Partha-Sarath-0/demo/09_Records_MD/correction_register.md

# GRAIL CFD — Correction Register
Every entry states the old assumption, the corrected assumption, the reason, what it affects,
and whether prior results must be discarded.

| ID | Old assumption | Corrected assumption | Reason | Affects | Discard old results? |
|---|---|---|---|---|---|
| CR-01 | Channel DIVERGES, Dh 5.20 → 8.345 mm | Channel CONVERGES, Dh 5.200 → 2.786 mm (as-meshed) | The diverging build violated ROADMAP A7/6.1/8.2 and fell outside Filing 1 dependent claim 1 (G must decrease, 0.35–1.00) | All hydraulic, thermal and efficiency results | YES — obsolete and scientifically invalid. Never a baseline, validation case, comparison or figure. |
| CR-02 | Single glazing pane, tau_glz = 0.91 | Double glazing, tau_glz_sys = 0.833 | The built collector has two panes (decision D2). Absorbed flux 567.1 → 519.1 W/m² at the design point | Optical chain, absorbed-flux BC, every efficiency figure | YES for any absorbed-flux value computed from 0.91 |
| CR-03 | Three-channel strip with plain SYMMETRY planes | Symmetry is not exact under alternating flow; field is glide-symmetric, not mirror-symmetric | Neighbour across a bridge midline runs the opposite direction; an adiabatic plane suppresses the lateral conduction Filing 1 depends on | Domain choice, all mechanism results | Not yet — decided by the domain-equivalence study (Gate 6) |
| CR-04 | lambda_G unspecified / assumed non-linear | lambda_G = 1.0 baseline | Confirmed against the as-built geometry: measured Dh(x) follows the linear-in-Dh law to +0.19 % … +0.49 % at xi = 0.10–0.90 | Grading sensitivity study | No |
| CR-05 | Root fillet 1.0 mm | Root fillet 0.5 mm (decision D4) | At 1.0 mm the tangent-blend section degenerates at h_s = 3.0 mm, flooring section scale at 0.745525 and making G_ratio 0.54 unreachable | Channel section, mesh near the root, fillet sensitivity 0.5–2.0 mm | YES for any result computed at r_fillet = 1.0 claiming G = 0.54 |
| CR-06 | Bridge width 34.8 mm (roadmap B3 baseline) | 31.299046 mm as built; investigate 20–60 mm | As-built value follows from ch_pitch − ch_w_in·max(1, G_ratio) | Lateral conduction, bridge sensitivity | No — 34.8 mm remains a valid sweep point |
| CR-07 | Manifold transition pockets as originally modelled | Pockets intentionally reduced; CFD circuit differs from the hardware-solid union by ~452.934 mm³ | Sub-0.5 mm lands would create poor CFD topology | Geometry provenance only | No — this is a deliberate modification, not an error |
| ~~CR-08~~ | ~~Grading ratio 0.540339~~ | **WITHDRAWN — see CR-09** | The premise was wrong. | — | — |
| **CR-09** | CR-08 claimed the STEP translation shifted the channel's small end, giving G = 0.535763 (−0.85 %) | **The geometry is faithful. G = 0.539935, −0.075 % from CAD.** The error was in the measurement tool, not the model: `gmsh.model.occ.getMass` mis-integrates the small trimmed outlet face by −0.72 % and the channel volume by +0.27 % | Direct integration of the true NURBS surface converges, under h-refinement of the sampling (NU = 96 → 2304), on the **CAD** values, not the OCC values. Inlet area → 28.0569 (CAD 28.0552, +0.006 %); outlet area → 7.9214 (CAD 7.9200, +0.018 %; OCC 7.8630, **+0.743 %**); volume → 18,643.7 (CAD 18,643.963, −0.0015 %) | Every quantity CR-08 said to restate. Reverted: the CAD values govern after all | **YES — discard CR-08 itself.** No CFD had been run on it. |
| **CR-10** | Assembly-level mesh renders showed the channel GROWING to Dh = 8.300 mm, a 1.0 mm root fillet, and stated 3,228,850 surface elements over 138 bodies at 20 mm cap with 23.97 m² of surface | Rebuilt on the corrected STEP: **128 of 129 solids, 299,544 triangles, 20 mm cap, 17.39 m² tessellated surface, envelope 1270 × 636 × 148 mm**; the channel SHRINKS 5.199 → 2.807 mm with a 0.5 mm root fillet | The old renders were made on the withdrawn diverging geometry (CR-01) and the 1.0 mm fillet (CR-05). They cannot be reused, re-captioned or cited | Figures M6–M10 and any body/element/area count quoted from them | **YES** — the superseded assembly renders are withdrawn with the geometry they depict |
| **CR-11** | (new) | The four manifold barrels (full periodic cylinder faces, CAD faces 430/478/542/590) are **rendered without their branch-port holes**, and the roll-bond solid region is built at a **nominal uniform 1.0 mm sheet thickness** | The barrels' port holes straddle the parametric seam, which defeats both gmsh's 2-D mesher and a point-in-polygon trim test; the real roll-bond upper sheet thins over the dome (marched thickness 0.22 – 1.32 mm, mean 1.08 – 1.23 mm) | M6–M10 only. Quantified, not hidden: the port area is computed from the CAD boundary curves and **subtracted** from the quoted surface area (−813.1 mm² over 92 arc segments); the solid region lands **+1.42 %** on the CAD sheet-pair volume | No — labelled ENGINEERING_ASSUMPTION, affects rendering and solid-region volume only, not any solved result |
| **CR-03 (closed)** | "Symmetry is not exact under alternating flow" — an argument, with the domain question left open | **Measured and confirmed.** An adiabatic symmetry plane inflates lateral bridge conduction by **+66.70 %**; a 3-channel strip is invalid under either boundary condition because the glide period is 2 channels; the **2-channel periodic** domain reproduces the full plate to Δη −0.31 %, Δ spread +2.51 %, Δ bridge −4.06 % | Five domains at identical cell size, with co-current as a control in which all four reduced domains reproduce the full plate exactly | Future reduced-domain work only. The campaign, mechanism study and all figures used the full 12-channel plate | No — nothing reported was computed on a reduced domain |
| **CR-12** | Lateral bridge conduction quoted as "170.84 W against 0.0000 W" | Co-current is **exactly zero by symmetry**, not merely small. The campaign reads 6.5e-11 to 9.1e-11 W (round-off); the grid study reads 0.000, 8.892, 0.000 and 3.345 W across four levels, and the 3-channel domain reads 1.050 W | Those nonzero readings are a sampling artefact of the bridge midline not coinciding with a cell face. With every channel flowing the same way the plate field is periodic in y and the midline gradient vanishes identically | How the contrast is quoted | No — quote it as an absolute figure (alternating 67 – 303 W across the campaign, ~20 W per midline at the design point), never as a ratio to zero |

| **CR-13** | Production campaign run at `nu_cfd = 3.4282`, the value measured on the medium 3-D grid | **Recomputed at `nu_cfd = 2.9238`**, the Richardson-extrapolated value from the three-level 3-D study (observed order p = 1.283, GCI 11.6 %). Rev 1 carried a **+17.25 %** bias on the one input the sensitivity analysis found controls 91 % of the uniformity difference | Same seed, same Latin Hypercube, same bounds, same gates, same grid — only `nu_cfd` changed, so every Rev 2 row pairs one-to-one with its Rev 1 twin and the difference is attributable to nothing else | Every campaign-derived number and every campaign figure (C10–C13, C17–C22). Paired shift: alternating plate spread −0.473 K, co-current −0.036 K | **No — Rev 1 is kept on disk** as `10_dataset/GRAIL_CFD_dataset_corrected.csv` and its figures under `12_figures/rev1_nu3.4282/`. Rev 2 (`GRAIL_CFD_dataset_rev2.csv`) supersedes it for every reported result |
| **CR-14** | Campaign average taken over 150 co-current and 141 alternating rows, the 9 missing rows dismissed as a convergence gate | **Rev 1's campaign average was censored.** The 9 rows the gate removed were all alternating, and all of them were the lowest-flow cases in the sample: 1.10 g/s mean against a 2.75 g/s campaign mean, none above 1.19 g/s, with a mean plate spread of 10.97 K against 4.69 K for alternating overall | Rev 2 loses no rows at all — the lower Nusselt number leaves the coupled solve better conditioned — so the 9 are recoverable and are not a random 9. Averaging with a sample's own hardest cases removed flatters alternating | The headline uniformity number, and the "benefit threshold" claim | **No result discarded, but the headline changes.** Δ plate spread: Rev 1 on 291 rows −20.09 %, Rev 2 on the same 291 rows −27.60 %, Rev 2 on all 300 rows **−20.83 ± 12.09 % (k = 2)**. The two corrections are of opposite sign and nearly cancel. The uncensored figure is the one to quote |
| **CR-15** | The 1.81 g/s mass-flow threshold below which alternating was said to be *worse* than co-current | **There is no threshold in the corrected campaign.** Every one of the 8 mass-flow bins from 1.23 to 4.27 g/s favours alternating in Rev 2; in Rev 1 the lowest bin read +7.75 % | Two causes, both in CR-13 and CR-14: the biased Nusselt number, and the fact that the censored rows were precisely the low-flow ones that set the threshold | Any statement of a minimum operating flow for the alternating arrangement | **YES — withdraw the threshold claim.** Note the bin-to-bin scatter is sampling noise: the co-current and alternating halves are two *independent* Latin Hypercube draws, so only the sign, which is consistent across all 8 bins, is robust |
| **CR-16** | Collapsing Nu(ξ) to a single number treated as a minor simplification | **It is the largest single model-form term in the assessment.** At the same developed-region mean, carrying the measured Nu(ξ) profile changes Δ plate spread from **−21.09 % to −6.85 %** — a shift of **14.2 percentage points**, larger than every numerical and input uncertainty combined. With the profile at its as-measured level the figure is −2.14 % | Closeout check A: the same solver at 220×240 run with a constant Nu, with the measured L3 profile, and with that profile rescaled to the constant's developed-region mean, which separates the cost of the profile's *shape* from the cost of its *level* | The confidence attached to the uniformity claim, not the sign of it — Δη moves only from −4.94 % to −5.51 % | **No result discarded**, but the uniformity benefit must be quoted as **model-form limited**. The campaign uses a constant Nu; a campaign carrying Nu(ξ) has not been run |
| **CR-17** | "3-D conjugate run on the meshed solid region" listed as an open item, implying it was pending rather than attempted | **Attempted and unsuccessful.** The two-region mesh builds and verifies (0 inverted cells, conformal interface at exactly NU × NX × 2 faces, fluid skewness 0.63 against 1.24 on the validated baseline), but `chtMultiRegionSimpleFoam` diverges from the first iteration: max \|U\| 155 m/s against an expected 0.00745 m/s | `simpleFoam` on the identical fluid region is stable (max \|U\| 0.098 m/s), so the mesh is solvable and the compressible segregated solver on it is not. Seven solver-setting changes were tried, including the exact scheme and relaxation set from the validated baseline case; none fixed it | Nothing — **no conjugate result is reported anywhere in this work** | **No.** Full account in `14_provenance/cht_attempt_record.md`. The question the run was meant to close stays open and is stated as open |
