Partha-Sarath-0/demo/Adaptive_Live_ANN_Concept.docx

# Adaptive / Live Artificial Neural Network (ANN)

Concept: Instead of training an ANN once on a fixed dataset, build a system that can adapt when new data arrives or when the underlying data pattern changes.

# 1. Traditional ANN

A conventional ANN is usually trained on a fixed dataset and then used for prediction.

Dataset → Train ANN → Model → Prediction

When new data arrives, the model is normally retrained manually or periodically.

# 2. Your Proposed Idea

The goal is an ANN that can continuously or periodically adapt itself to new information.

New Data → Check Pattern/Data Change → Check Model Performance → Update or Keep Model

# 3. Online / Incremental Learning

The first step is to allow the model to learn from new data without always starting training from zero.

Example:

- Day 1: 10,000 samples → train ANN
- Day 2: +500 samples → update ANN
- Day 3: +700 samples → update ANN
- Day 4: +1,000 samples → update ANN

# 4. Adaptive / Live ANN

A more advanced system monitors incoming data and detects whether the data distribution or relationship between inputs and outputs has changed.

Typical flow:

1. New data arrives
2. Process and validate the data
3. Detect data drift or concept drift
4. If the pattern is stable, continue using the current model
5. If a significant change is detected, update or retrain the model
6. Validate the new model
7. Deploy the new model only if it meets the required performance criteria

# 5. Important Terms

Online learning: Learning continuously or in small batches as new data arrives.

Incremental learning: Updating an existing model with additional data rather than rebuilding it from scratch.

Continual learning: Learning over an extended sequence of new data/tasks while trying to retain previous knowledge.

Data drift: A change in the distribution of the input data.

Concept drift: A change in the relationship between inputs and the target/output.

Model monitoring: Tracking prediction quality and other model-health metrics over time.

# 6. Proposed Architecture

Live Data → Data Processor → Drift Detector → ANN → Prediction → Performance Monitor

If drift/performance degradation is detected: New Data → Retraining/Incremental Update → Validation → New Model → Deployment

# 7. Recommended Development Stages

Stage 1: Build a normal ANN using Python and a fixed dataset.

Stage 2: Add incoming batches of new data and incremental/periodic training.

Stage 3: Add drift detection and model-performance monitoring.

Stage 4: Create an automated retraining and validation pipeline.

Stage 5: Connect the system to a genuinely live data source.

# 8. Key Design Principle

The ANN should not blindly retrain every time new data arrives. A robust adaptive system should decide when an update is necessary, whether incremental training is sufficient, whether a full retraining is needed, and whether the updated model performs better before deployment.

# 9. Practical Project Goal

A good first project would be a Python-based Adaptive ANN that receives simulated live data, detects a change in the data pattern, updates/retrains the ANN, compares the old and new models, and automatically deploys the updated model when its validation performance is acceptable.
