Partha-Sarath-0/demo/12_Stages_3-5-6-7/report/GRAIL_Stages_3-5-6-7_Report.docx

THE GRAIL COLLECTOR

Stages 3, 5, 6 and 7

ANN surrogate · NSGA-II optimisation · System model · Annual and techno-economic analysis, Berhampur (Odisha)

Item | Value
Input dataset | GRAIL_CFD_dataset_FINAL_rev4.2.csv (read-only, md5 13fd464c…)
Solver used for checks | GRAIL-CHT, Rev 4.2 settings, Richardson 2f(220) − f(110)
Weather | PVGIS TMY 19.313 N 84.810 E, 2005–2023, 8760 h (md5 63855e6f…)
Tariff | TPSODL LT domestic, 470 paise/kWh (51–200 kWh slab), FY 2025-26, retained FY 2026-27
Stage 4 (topology optimisation) | Removed from scope (future work)
Experimental validation | None claimed. All results are model results

# Contents

# 1. Summary

Stage | Result
3 ANN surrogate | Test R² 0.9994–0.9998 on 60 unseen cases (η MAPE 0.14 %). GPR slightly better (R² ≥ 0.9999); ANN kept as the roadmap model, GPR reported as the check
5 NSGA-II | Fronts for both arrangements. All 8 selected points re-run in GRAIL-CHT: η error ≤ 0.13 points, std ≤ 2.4 %, Δp ≤ 5.8 %. Parallel dominates on efficiency; alternating reaches the lowest plate std (2.83 K) at the top flow
6 System model | η0 0.597 / a1 2.00 W/m²K (alternating); η0 0.637 / a1 2.10 W/m²K (parallel). Fit error ≤ 0.23 points RMS; held-out points ≤ 0.24 points
7 Annual, Berhampur | Collector yield at 40 °C inlet: 1030 kWh/m²/yr parallel, 965 alternating (−6.3 %)
7 Techno-economic | Best size for 100 L/day: 2 modules (1.06 m²). Solar fraction 86 % / 83 %, cost of solar heat Rs 4.34 / 4.49 per kWh vs Rs 4.95 for an electric geyser, simple payback about 7.4 / 7.6 years (parallel / alternating)

Findings that the thesis must state as they are

1. Efficiency: parallel flow beats alternating in every stage — the dataset (−7.3 %), the Pareto fronts, the fitted curves and the annual yield (−6.3 %). Alternating only wins on plate uniformity at high flow, as Rev 4.1 found.

2. Converging channels: the optimiser pushes the grading ratio to its upper bound, 1.0 (a straight channel), and SHAP gives the grading inputs almost no effect on efficiency. Within the studied range, converging the channels does not raise efficiency; it raises pressure drop. DESIGN_REVIEW_REQUIRED for any claim that convergence improves thermal performance.

3. Pumping power in the channels is below 0.1 mW at every point, so it is not a real objective. Manifold and pump losses dominate in practice, and they are not modelled (manifold dimensions are still ENGINEERING_ASSUMPTION).

4. Optimum efficiency lies on the upper flow bound (4.5 g/s). The optimisation cannot say what happens beyond the sampled range.

5. Stagnation: with 4 modules the collector node reaches 427–442 K (154–168 °C) for up to 486 h/yr, outside the fitted range and probably above the TIM and PCM material limits. DESIGN_REVIEW_REQUIRED (overheat protection or smaller array). With the recommended 2 modules the maximum is 349–353 K.

# 2. Stage 3 — ANN surrogate

## 2.1 Method

- Inputs (9, sampled model inputs only, no derived columns): G_T, T_in, T_amb, wind, total mass flow, bridge width, grading ratio, grading exponent, arrangement flag.
- Targets: η, plate std, ln(Δp), mean plate temperature.
- Split: 240 training / 60 test cases, stratified by arrangement, seed 42. The test set was not used in any tuning step.
- Tuning: 5-fold cross-validated grid over 6 architectures × 5 L2 penalties; tanh activation, L-BFGS training, standardised inputs and targets.
- Final model: 10-member ensemble of the tuned network (different seeds); the ensemble spread is kept as an uncertainty indicator.
- Baselines on the same split: linear regression and Gaussian-process regression.

## 2.2 Results

Target | Architecture, α | CV R² | ANN test R² | ANN MAPE % | GPR test R² | Linear test R²
eta | [64, 32], 0.01 | 0.9994 | 0.9997 | 0.14 | 0.9999 | 0.8897
plate_std_K | [32, 32], 0.01 | 0.9993 | 0.9996 | 0.53 | 1.0000 | 0.8519
log_dp_Pa | [64, 32], 0.01 | 0.9992 | 0.9998 | 0.92 | 1.0000 | 0.9747
T_plate_mean_K | [64, 32], 0.01 | 0.9992 | 0.9994 | 0.06 | 1.0000 | 0.8813

Table 1. Surrogate accuracy on the 60-case hold-out set

The linear model reaches only R² 0.85–0.97, so the response is clearly non-linear; the ANN captures it. The GPR is marginally more accurate on this smooth 300-case dataset. Both are far inside the solver's own numerical uncertainty, so the choice does not change any conclusion.


Figure 15. Parity plots, test set

## 2.3 SHAP

Mean |SHAP| on the test set. Efficiency is driven by T_in, T_amb, flow and arrangement. The three geometric inputs (bridge, grading ratio, grading exponent) are two orders of magnitude weaker. Plate uniformity is driven by flow and irradiance. Pressure drop is driven by grading ratio and flow — the only place where the converging geometry matters strongly.

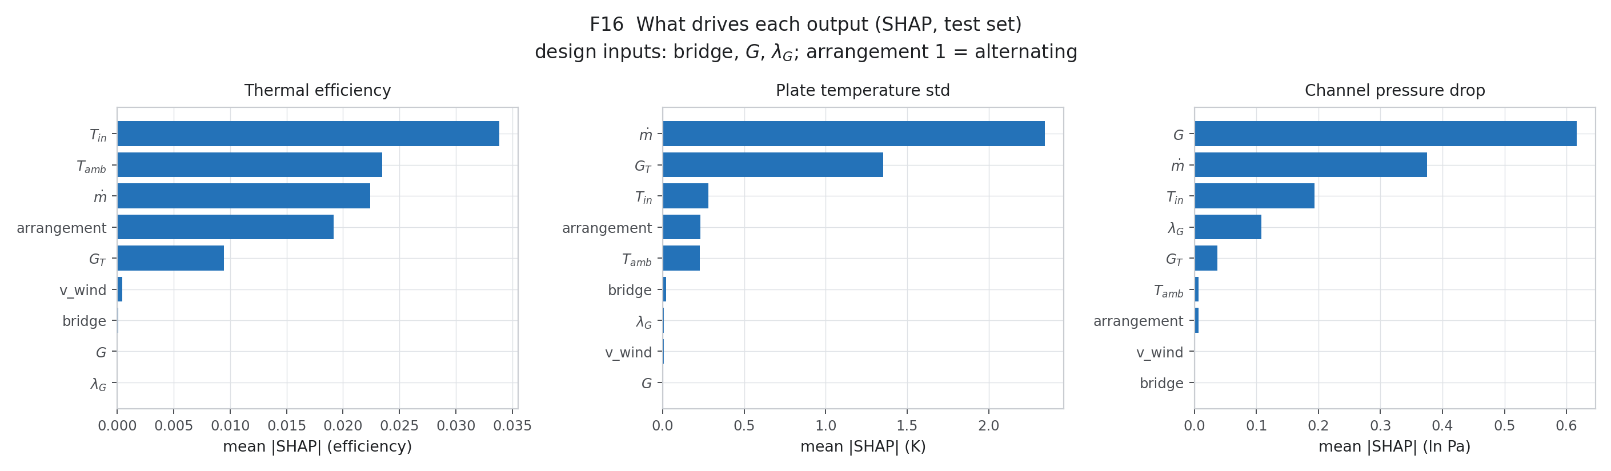
[picture p85: figure]

Figure 16. SHAP importance

# 3. Stage 5 — NSGA-II optimisation

- Variables inside the campaign bounds: flow 1.0–4.5 g/s, bridge 20–37 mm, grading ratio 0.35–1.0, grading exponent 0.5–2.0. Each arrangement was optimised separately and the fronts were merged.
- Reference point (ENGINEERING_ASSUMPTION, Berhampur clear-sky noon): G 800 W/m², T_in 313.15 K, T_amb 303.15 K, wind 3 m/s.
- Objectives: maximise η, minimise plate std, minimise pumping power. Population 200, 250 generations, seed 7.


Figure 17. Pareto fronts

Arrangement | Pick | Flow g/s | Bridge mm | Grading ratio | Exponent | η ANN | η GRAIL-CHT | std ANN K | std CHT K | Δp error %
alternating | max_eta | 4.49 | 31.9 | 0.998 | 0.50 | 0.5783 | 0.5784 | 2.87 | 2.83 | 5.8
alternating | min_std | 4.49 | 37.0 | 0.708 | 1.35 | 0.5773 | 0.5782 | 2.83 | 2.87 | 0.0
alternating | knee | 3.28 | 31.0 | 0.997 | 1.21 | 0.5599 | 0.5601 | 4.80 | 4.82 | -0.5
parallel | max_eta | 4.49 | 33.9 | 0.998 | 0.50 | 0.5940 | 0.5943 | 3.71 | 3.76 | 5.3
parallel | min_std | 4.49 | 37.0 | 0.998 | 2.00 | 0.5931 | 0.5944 | 3.68 | 3.76 | -0.3
parallel | knee | 2.94 | 27.6 | 0.998 | 1.40 | 0.5852 | 0.5850 | 5.64 | 5.64 | -0.7
alternating | as_built | 2.75 | 31.3 | 0.540 | 1.00 | 0.5467 | 0.5466 | 6.29 | 6.27 | -0.2
parallel | as_built | 2.75 | 31.3 | 0.540 | 1.00 | 0.5834 | 0.5830 | 6.00 | 6.01 | -0.0

Table 2. Selected points re-run with GRAIL-CHT (all converged, energy error < 0.5 %)

Every selected point was re-run with the solver; the surrogate holds to 0.13 efficiency points. The as-built design sits almost on each front. Moving it along the front is mainly a matter of flow: more flow gives higher efficiency and a flatter plate.

# 4. Stage 6 — System model

## 4.1 Efficiency correlations (virtual steady-state test)

The as-built geometry (bridge 31.29 mm, G 0.539935, λ 1.0) at the design flow of 2.75 g/s was run in GRAIL-CHT at 22 points: G ∈ {500, 900} W/m² × T_in ∈ {293, 308, 323, 332} K for the fit, and 3 held-out points (wind 0.5 and 4.9 m/s, T_amb 288 K). The ISO 9806 steady form was fitted on the mean fluid temperature.

Arrangement | η0 | a1 W/m²K | a2 W/m²K² | Fit RMS (points) | Held-out errors (points) | Wind 0.5 → 4.9 m/s
alternating | 0.5966 | 2.004 | 0.00038 | 0.15 | 0.24, -0.01, 0.15 | 0.5297 → 0.5279 → 0.5273
parallel | 0.6368 | 2.104 | 0.00000 | 0.23 | 0.15, 0.10, -0.04 | 0.5643 → 0.5639 → 0.5638

Table 3. Collector efficiency correlations (aperture 0.528 m², incident irradiance)

Parallel's unconstrained a2 was slightly negative (−0.0006), which is unphysical. It was refitted with a2 = 0; both fits are on record. The heat-loss coefficient a1 ≈ 2 W/m²K is very low because of the TIM, PCM and VIP stack. η0 ≈ 0.60–0.64 is set mainly by the optical factor 0.6489. Wind changes efficiency by less than 0.3 points, so no wind term was fitted. The fit covers Tm − Ta from −3 to 40 K.


Figure 18. Efficiency curves

## 4.2 Dynamic collector and tank model

- Collector: one thermal node in the ISO 9806 quasi-dynamic form. Effective capacity 33.5 kJ/m²K from the stack masses (PCM counted as sensible heat only — PCM latent heat is deferred).
- Incidence angle modifier: Kb = 1 − 0.10(1/cos θ − 1), diffuse 0.90 (ENGINEERING_ASSUMPTION; the solver has no angular optics).
- Tank: 100 kg, fully mixed, UA 1.5 W/K. Pump control: on at ΔT > 7 K, off below 2 K, off above 358 K. 60 s step. The tank first law closes to 0.000 kWh/yr.
- Load: 100 L/day delivered at 318.15 K through a mixing valve, drawn 40/20/40 % morning/noon/evening; mains water at the 24 h mean ambient temperature; electric top-up at 95 % efficiency.

## 4.3 Roadmap Section 11 — GNU Octave implementation

Section 11 of the roadmap specifies MATLAB/Simulink. No MATLAB or Simulink licence was available, so the system model was also written as MATLAB-compatible .m files and run in GNU Octave 8.4.0 (folder 13_Octave_system_model). It uses the same equations and inputs but its own solar-position routine (NOAA rather than NREL SPA). The results match the Python model: solar fraction within 0.000004, solar heat within 0.003 kWh/yr, cost of heat within 0.00004 Rs/kWh, collector-only yield within 0.004 kWh/m²/yr, peak collector temperature within 0.17 K. The tank energy balance closes to about 1e-12 kWh. No Simulink model exists. The block-diagram part of Section 11 was built in Scilab Xcos instead (Section 4.4).

## 4.4 Roadmap Section 11 — block-diagram model in Scilab Xcos

Simulink needs a MATLAB licence, so the same collector–tank system was drawn as a block diagram in Scilab Xcos 2024.0.0, the free equivalent (folder 14_Xcos_block_diagram_model, file GRAIL_system.zcos). The diagram has 24 blocks:

- Hourly inputs: G_eff, T_amb, T_mains and draw, from the unchanged TMY file.
- Two integrators for the collector and tank temperatures.
- A hysteresis block for the pump (7/2 K) with a 358 K tank limit.
- Expression blocks for the two energy balances and for six heat rates, which are integrated and logged to the workspace.
- The solver is LSodar (tolerance 1e-6, maximum step 60 s). A full year runs in 7–10 s.

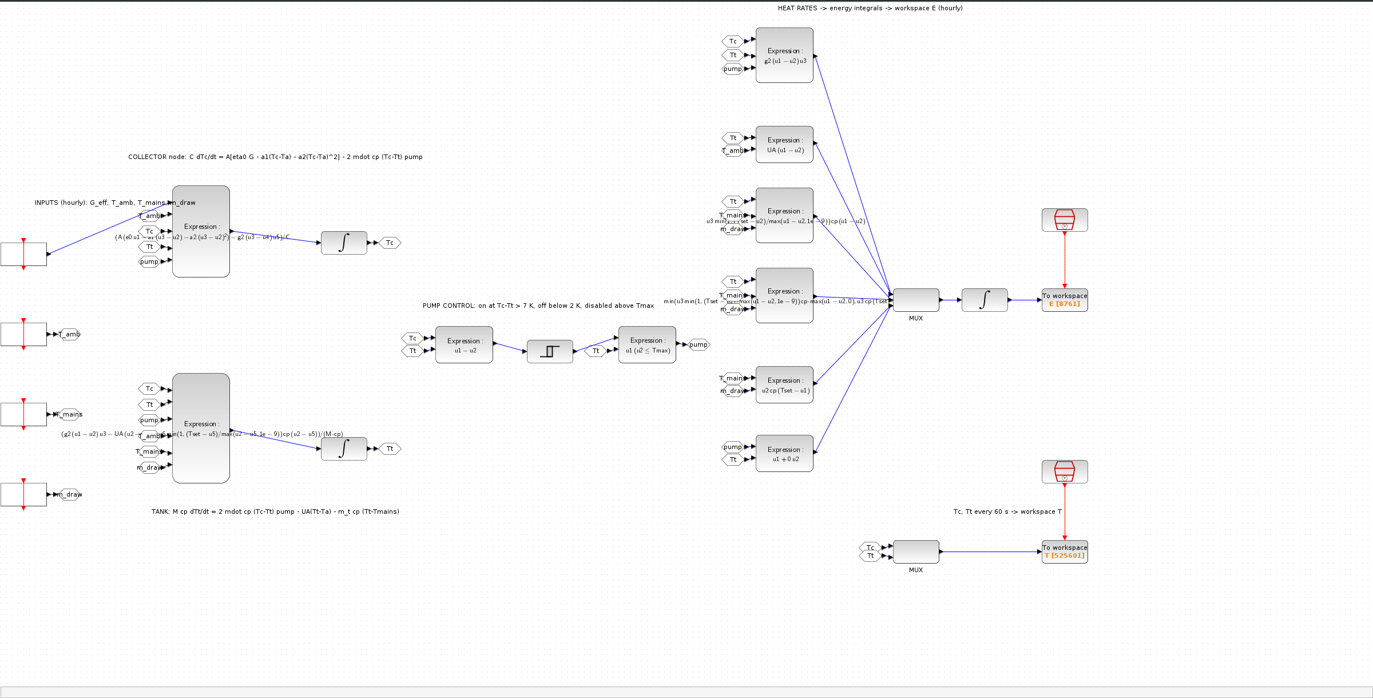
[picture p86: figure]

Figure 18a. GRAIL SDHW system as a Scilab Xcos block diagram

Arrangement | Modules | Solar kWh/yr | SF Xcos % | SF Octave (same equations) % | SF Stage 7 baseline % | Max Tc K
alternating | 2 | 626.0 | 81.42 | 81.46 | 83.04 | 348.0
parallel | 2 | 648.4 | 84.34 | 84.36 | 85.84 | 352.0
alternating | 4 | 749.7 | 97.51 | 97.52 | 97.91 | 429.8
parallel | 4 | 754.1 | 98.08 | 98.08 | 98.43 | 443.8

Table 3a. Xcos results and verification (Berhampur TMY, 100 L/day at 45 °C)

Verification (model-to-model only; no experimental validation):

- Against an Octave solution of the same equations at a 10 s step, solar heat agrees within 0.04 % and solar fraction within 0.03 points in all four cases.
- The tank first law closes to better than 1e-10 kWh.
- Re-importing the saved .zcos file reproduces the results.

The Xcos model treats each hour's hot-water draw as a continuous flow; the Stage 7 model draws it as a pulse at the start of the hour. This modelling choice lowers the solar fraction by 1.5–1.6 points at 2 modules and 0.4 points at 4 modules. The ranking (parallel above alternating) and the sizing conclusion (2 modules) are unchanged. The Stage 7 figures remain the reported baseline.

# 5. Stage 7 — Annual and techno-economic analysis, Berhampur

## 5.1 Weather processing

- The time alignment was tested, not assumed: GHI = DNI cos z + DHI closes to 0.17 W/m² when the solar position is taken at the stated UTC timestamp, against 14.3 W/m² with a half-hour shift.
- Plane of array: 19.3° tilt, facing south, Hay-Davies, albedo 0.2 → 1976 kWh/m²/yr. Isotropic model 1955, Perez 2001; tilts between 15° and 25° are within 0.5 %.
- Cross-check: at 35° tilt the result is 1935 kWh/m²/yr, against 1965 in the PVGIS PV report you downloaded (a different database) — 1.5 % apart.

Arrangement | Yield at 40 °C inlet (kWh/m²/yr) | Yield at 60 °C inlet | Annual efficiency on POA at 40 °C
parallel | 1030 | 882 | 52.1 %
alternating | 965 | 823 | 48.8 %

Table 4. Collector-only annual yield at fixed inlet temperature


Figure 19. Monthly yield, sizing and cost of heat

## 5.2 Household system sizing and economics

Arrangement | Modules | Area m² | Solar fraction | Solar heat kWh/yr | Max collector K | Capex Rs | Payback yr | NPV Rs | Cost of heat Rs/kWh
alternating | 1 | 0.53 | 50.0 % | 385 | 329 | 16500 | 10.8 | -3464 | 6.00
alternating | 2 | 1.06 | 83.0 % | 638 | 349 | 21000 | 7.6 | 2526 | 4.49
alternating | 3 | 1.58 | 94.7 % | 728 | 389 | 25500 | 8.0 | 1620 | 4.69
alternating | 4 | 2.11 | 97.9 % | 753 | 427 | 30000 | 9.2 | -1976 | 5.25
parallel | 1 | 0.53 | 53.2 % | 409 | 331 | 16500 | 10.1 | -2461 | 5.65
parallel | 2 | 1.06 | 85.8 % | 660 | 353 | 21000 | 7.4 | 3435 | 4.34
parallel | 3 | 1.58 | 96.0 % | 738 | 405 | 25500 | 7.9 | 2053 | 4.62
parallel | 4 | 2.11 | 98.4 % | 757 | 442 | 30000 | 9.1 | -1748 | 5.22

Table 5. Sizing sweep for a 100 L/day household (15 years, 8 % discount rate, 1 % O&M, 15 W pump)

- Tariff: TPSODL domestic 470 paise/kWh (51–200 kWh slab), unchanged for FY 2026-27; electricity duty excluded (conservative). At the 570 paise slab, savings rise by 21 %.
- Capex: ENGINEERING_ASSUMPTION of Rs 12,000 fixed + Rs 4,500 per module, anchored to market flat-plate systems (Rs 20,000–30,000 for 100 L/day plus Rs 3,000–10,000 installation). The GRAIL prototype cost is unknown; the base case (4 modules) is also run at Rs 22,000 and Rs 45,000 in stage7_results.json.
- Two modules minimise the cost of heat. Four modules are oversized: the tank sits at its limit for 533–726 h/yr, 40 % of the collected heat is lost from the tank, and the collector stagnates at high temperature.

# 6. Assumptions, open items and files

Tag | Item
ENGINEERING_ASSUMPTION | Tilt 19.3° S; IAM b0 0.10; C_eff 33.5 kJ/m²K; tank 100 kg, UA 1.5 W/K; 100 L/day at 45 °C; draw profile; mains = 24 h mean ambient; pump 15 W; geyser 95 %; capex model; 15 yr, 8 %, 1 % O&M
ENGINEERING_ASSUMPTION | NSGA-II reference operating point; design flow 2.75 g/s for the annual runs
DESIGN_REVIEW_REQUIRED | Converging-channel benefit (not supported for efficiency within the range studied)
DESIGN_REVIEW_REQUIRED | Stagnation temperature against TIM and PCM limits for arrays of 3 or more modules; overheat protection
Deferred (your decision) | PCM latent heat, 3-D radiation and optical model, full 3-D campaign; manifold dimensions
Limitation | Annual results rely on the fitted correlation outside its fitted range only during stagnation hours; wind above 5 m/s (1,605 h) is outside the trained range but has less than 0.3 points of effect

Folder | Contents
21_surrogate | ann_surrogate.pkl, stage3_report.json, test parity CSVs, SHAP arrays
23_optimisation | pareto_fronts.csv, selected_points_surrogate.csv, verification_vs_GRAIL-CHT.csv
22_system | virtual_test_matrix.csv, efficiency_correlations.json
20_annual | weather file (unchanged), closure test, stage7_results.json, sizing_sweep.csv, hourly SDHW CSVs, monthly yield
24_figures_stage3to7 | F15–F19
13_Octave_system_model | MATLAB/Octave .m model, compare_with_python.m (PASS), continuous-draw reference for Xcos, README
14_Xcos_block_diagram_model | GRAIL_system.zcos block diagram, build/run scripts, inputs, results, verification (PASS), README
tools | stage3_ann.py, stage5_nsga2.py, stage5_verify.py, cht_point.py, stage6_testmatrix.py, stage6_fit.py, stage7_weather.py, stage7_annual.py, stage3to7_figures.py

GRAIL Collector — Stages 3, 5, 6, 7
