Partha-Sarath-0/demo/16_JSON_Python_Mirror/README.md

# 16 — JSON ↔ Python mirror

Every JSON file in the package (65) now has a Python file next to it in this folder. There are
two parts:

1. **`mirror/`: the same data as Python.** There is one `.py` file per JSON, at the same path,
   for example `07_Results_JSON/validation_and_uncertainty/gci_plate.json` →
   `mirror/07_Results_JSON/validation_and_uncertainty/gci_plate.py`. Each file contains:
   * `DATA`, the full content as an indented Python dict or list in the same key order;
   * a header saying what the file holds, which script made the JSON, the MD5/SHA-256 of the
     JSON, and an outline of its keys;
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
