Partha-Sarath-0/demo/06_Datasets/GRAIL_CFD_dataset_rev4.2_with_Stages3-7.xlsx

Sheet: README
GRAIL Collector - CFD dataset rev 4.2 with Stage 3-7 results
Dataset_rev4.2: the 300 GRAIL-CHT cases, copied cell for cell from GRAIL_CFD_dataset_FINAL_rev4.2.csv.
The CSV file itself is unchanged (MD5 13fd464c09a7c26fbe0fa75a5f5113b3, the MD5 recorded by Stage 3).

Sheet: Dataset_rev4.2
case_id | geometry_version | solver | arrangement | f_interdig | G_T_W_m2 | T_in_K | T_amb_K | v_wind_m_s | mdot_total_kg_s | mdot_channel_kg_s | bridge_mm | g_ratio | lambda_G | Dh_in_mm | Dh_out_mm | A_in_mm2 | A_out_mm2 | Re_in | Re_out | mu_Pa_s | dp_channel_Pa | W_pump_W | q_abs_W_m2 | T_sky_K | h_wind_W_m2K | T_out_K | dT_fluid_K | Qu_W | eta | T_plate_mean_K | T_plate_max_K | T_plate_min_K | plate_spread_K | plate_std_K | P90_K | P95_K | P99_K | R4_K4 | Tmean_pow4_K4 | T_R4_K | Q_solar_W | Q_rad_W | Q_conv_W | Q_rear_W | U_L_W_m2K | T_glass_mean_K | lateral_bridge_W | energy_error_pct | outer_iters | residual | converged | Nu_closure_input | Nu_closure_basis | dataset_rev | k_model | outer_cap | plate_nx | plate_ny
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

Sheet: Stage6_Correlations
Stage 6 - ISO 9806 steady-state efficiency, q = eta0 G - a1 dT - a2 dT^2 (dT = Tm - Ta)
Quantity | Alternating | Parallel | Unit | Source file
eta0 | 0.5966 | 0.6368 | - | 12_Stages_3-5-6-7/system_model/efficiency_correlations.json
a1 | 2.004 | 2.104 | W/m2K | 12_Stages_3-5-6-7/system_model/efficiency_correlations.json
a2 | 0.00038 | 0.00000 | W/m2K2 | 12_Stages_3-5-6-7/system_model/efficiency_correlations.json
Fit RMS error | 0.151 | 0.229 | points | 12_Stages_3-5-6-7/system_model/efficiency_correlations.json
Fit max error | 0.318 | 0.434 | points | 12_Stages_3-5-6-7/system_model/efficiency_correlations.json
a2 constraint | not active | a2 >= 0 enforced |  | 12_Stages_3-5-6-7/system_model/efficiency_correlations.json
Unconstrained a2 (parallel) |  | -0.00061 | W/m2K2 | negative (unphysical), so refitted with a2 = 0; both fits on record
Held-out GRAIL-CHT points (not used in the fit)
Arrangement | G | T_in | T_amb | wind | eta_cht | eta_fit | err_pp | |error| (points) | Source file
alternating | 900.0000 | 323.1500 | 303.1500 | 0.5000 | 0.5297 | 0.5273 | 0.2386 | 0.239 | 12_Stages_3-5-6-7/system_model/efficiency_correlations.json
alternating | 900.0000 | 323.1500 | 303.1500 | 4.9000 | 0.5273 | 0.5274 | -0.0116 | 0.012 | 12_Stages_3-5-6-7/system_model/efficiency_correlations.json
alternating | 700.0000 | 332.1500 | 288.1500 | 3.0000 | 0.4500 | 0.4485 | 0.1532 | 0.153 | 12_Stages_3-5-6-7/system_model/efficiency_correlations.json
parallel | 900.0000 | 323.1500 | 303.1500 | 0.5000 | 0.5643 | 0.5627 | 0.1507 | 0.151 | 12_Stages_3-5-6-7/system_model/efficiency_correlations.json
parallel | 900.0000 | 323.1500 | 303.1500 | 4.9000 | 0.5638 | 0.5628 | 0.1050 | 0.105 | 12_Stages_3-5-6-7/system_model/efficiency_correlations.json
parallel | 700.0000 | 332.1500 | 288.1500 | 3.0000 | 0.4809 | 0.4813 | -0.0423 | 0.042 | 12_Stages_3-5-6-7/system_model/efficiency_correlations.json
Largest held-out error (points) | 0.239
Fit based on 22 GRAIL-CHT runs (G 500/900 W/m2 x 4 inlet temperatures, both arrangements) plus these held-out points.

Sheet: Stage7_Annual
Stage 7 - Annual performance, Berhampur (PVGIS TMY 2005-2023, tilt 19.3 deg S, Hay-Davies)
Quantity | Value | Unit | Source file
Global horizontal irradiation (GHI) | 1864.9 | kWh/m2/yr | 12_Stages_3-5-6-7/annual/stage7_results.json
Plane-of-array irradiation (POA) | 1976.1 | kWh/m2/yr | 12_Stages_3-5-6-7/annual/stage7_results.json
POA after incidence-angle losses | 1854.7 | kWh/m2/yr | 12_Stages_3-5-6-7/annual/stage7_results.json
Collector yield, 40 C (313.15 K) inlet - parallel | 1029.9 | kWh/m2/yr | 12_Stages_3-5-6-7/annual/stage7_results.json
Collector yield, 40 C (313.15 K) inlet - alternating | 965.2 | kWh/m2/yr | 12_Stages_3-5-6-7/annual/stage7_results.json
Collector yield, 60 C (333.15 K) inlet - parallel | 882.5 | kWh/m2/yr | 12_Stages_3-5-6-7/annual/stage7_results.json
Collector yield, 60 C (333.15 K) inlet - alternating | 823.4 | kWh/m2/yr | 12_Stages_3-5-6-7/annual/stage7_results.json
Weather cross-check at 35 deg tilt against the PVGIS PV report (PVGIS-ERA5)
Month | PVGIS H(i)_m (kWh/m2) |  | Source file
1 | 204.15 |  | 12_Stages_3-5-6-7/annual/weather/PVGIS_PVreport_35deg_crosscheck.csv
2 | 191.88 |  | 12_Stages_3-5-6-7/annual/weather/PVGIS_PVreport_35deg_crosscheck.csv
3 | 204.32 |  | 12_Stages_3-5-6-7/annual/weather/PVGIS_PVreport_35deg_crosscheck.csv
4 | 183.05 |  | 12_Stages_3-5-6-7/annual/weather/PVGIS_PVreport_35deg_crosscheck.csv
5 | 165.31 |  | 12_Stages_3-5-6-7/annual/weather/PVGIS_PVreport_35deg_crosscheck.csv
6 | 122.77 |  | 12_Stages_3-5-6-7/annual/weather/PVGIS_PVreport_35deg_crosscheck.csv
7 | 110.99 |  | 12_Stages_3-5-6-7/annual/weather/PVGIS_PVreport_35deg_crosscheck.csv
8 | 120.04 |  | 12_Stages_3-5-6-7/annual/weather/PVGIS_PVreport_35deg_crosscheck.csv
9 | 132.93 |  | 12_Stages_3-5-6-7/annual/weather/PVGIS_PVreport_35deg_crosscheck.csv
10 | 165.15 |  | 12_Stages_3-5-6-7/annual/weather/PVGIS_PVreport_35deg_crosscheck.csv
11 | 176.26 |  | 12_Stages_3-5-6-7/annual/weather/PVGIS_PVreport_35deg_crosscheck.csv
12 | 188.42 |  | 12_Stages_3-5-6-7/annual/weather/PVGIS_PVreport_35deg_crosscheck.csv
PVGIS year (sum) | 1965.3 | kWh/m2/yr
This model at 35 deg | 1935.5 | kWh/m2/yr | 12_Stages_3-5-6-7/annual/stage7_weather_check.txt (tilt 35 line)
Difference | -1.5%
SDHW sizing sweep: 100 L/day delivered at 45 C (318.15 K)
arrangement | n_modules | aperture_m2 | solar_fraction | Q_solar_kWh | yield_kWh_m2 | tank_loss_kWh | hours_tank_limit | max_collector_K | hours_collector_above_393K | capex_Rs | net_saving_Rs | simple_payback_yr | discounted_payback_yr | NPV_Rs | LCOH_Rs_kWh | Source file
alternating | 1 | 0.528 | 0.500 | 384.777 | 728.744 | 110.813 | 0 | 329.050 | 0 | 16500.000 | 1523.040 | 10.834 | 27 | -3463.574 | 5.999 | 12_Stages_3-5-6-7/annual/sizing_sweep.csv
alternating | 2 | 1.056 | 0.830 | 638.425 | 604.570 | 241.530 | 0 | 349.080 | 0 | 21000.000 | 2748.570 | 7.640 | 13 | 2526.329 | 4.485 | 12_Stages_3-5-6-7/annual/sizing_sweep.csv
alternating | 3 | 1.584 | 0.947 | 728.471 | 459.894 | 402.228 | 75 | 389.362 | 0 | 25500.000 | 3168.362 | 8.048 | 14 | 1619.525 | 4.688 | 12_Stages_3-5-6-7/annual/sizing_sweep.csv
alternating | 4 | 2.112 | 0.979 | 752.809 | 356.444 | 508.784 | 533 | 426.590 | 270 | 30000.000 | 3274.062 | 9.163 | 18 | -1975.733 | 5.254 | 12_Stages_3-5-6-7/annual/sizing_sweep.csv
parallel | 1 | 0.528 | 0.532 | 408.811 | 774.264 | 118.154 | 0 | 330.788 | 0 | 16500.000 | 1640.169 | 10.060 | 22 | -2461.007 | 5.651 | 12_Stages_3-5-6-7/annual/sizing_sweep.csv
parallel | 2 | 1.056 | 0.858 | 659.968 | 624.969 | 266.450 | 0 | 353.159 | 0 | 21000.000 | 2854.676 | 7.356 | 12 | 3434.537 | 4.339 | 12_Stages_3-5-6-7/annual/sizing_sweep.csv
parallel | 3 | 1.584 | 0.960 | 737.889 | 465.839 | 435.707 | 197 | 405.361 | 29 | 25500.000 | 3219.046 | 7.922 | 14 | 2053.353 | 4.622 | 12_Stages_3-5-6-7/annual/sizing_sweep.csv
parallel | 4 | 2.112 | 0.984 | 756.787 | 358.327 | 533.325 | 726 | 441.513 | 486 | 30000.000 | 3300.702 | 9.089 | 17 | -1747.707 | 5.217 | 12_Stages_3-5-6-7/annual/sizing_sweep.csv
DESIGN_REVIEW_REQUIRED: with 4 modules the collector stagnates above 420 K (max_collector_K).

Sheet: Economics
Economics - 2-module system (1.056 m2), 100 L/day at 45 C, Berhampur
Input | Value | Unit | Basis / source
Electricity tariff | 4.70 | Rs/kWh | TPSODL LT domestic 51-200 kWh/month slab, 470 paise/kWh (FY 2025-26, retained FY 2026-27); electricity duty excluded (conservative)
Electric geyser efficiency | 0.95 | - | 12_Stages_3-5-6-7/annual/stage7_results.json
Capex fixed part | 12000 | Rs | ENGINEERING_ASSUMPTION (Stage 7 sizing sweep)
Capex per module | 4500 | Rs/module | ENGINEERING_ASSUMPTION (Stage 7 sizing sweep)
Modules | 2 | - | best size from the sizing sweep
Life | 15 | yr | 12_Stages_3-5-6-7/annual/stage7_results.json
Discount rate | 0.08 | - | 12_Stages_3-5-6-7/annual/stage7_results.json
O&M per year (fraction of capex) | 0.01 | - | 12_Stages_3-5-6-7/annual/stage7_results.json
Capex (formula) | 21000 | Rs | 12,000 + 4,500 per module; checked against capex_Rs in the sizing sweep below
Capex check vs sizing sweep | OK
Cost of heat from an electric geyser | 4.95 | Rs/kWh | tariff / geyser efficiency
Result (2 modules) | Parallel | Alternating | Unit
Solar fraction | 85.8% | 83.0% | -
Solar heat delivered | 660.0 | 638.4 | kWh/yr
Cost of solar heat (LCOH) | 4.34 | 4.49 | Rs/kWh
Simple payback | 7.4 | 7.6 | yr
Discounted payback | 12 | 13 | yr
Net saving per year | 2854.675843 | 2748.570303 | Rs/yr
NPV over life | 3434.537043 | 2526.32893 | Rs
Solar heat cheaper than the geyser? | yes | yes
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
