Partha-Sarath-0/demo/03_CAD/strip_3ch.step

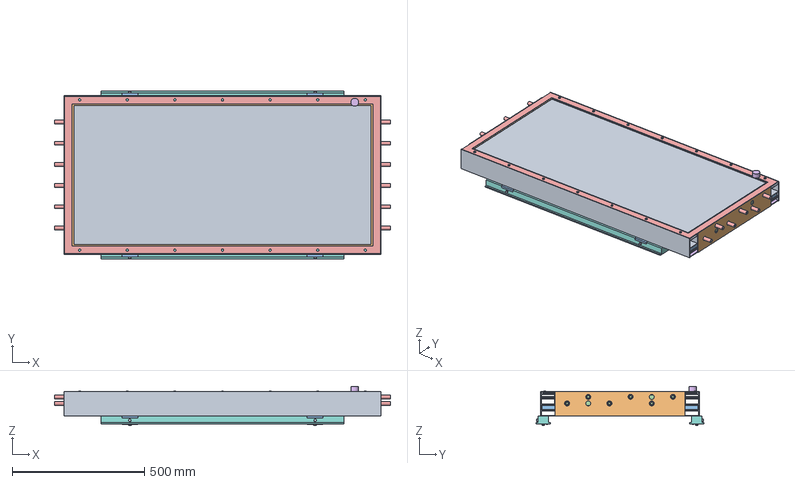
[picture p87: CAD file, 2026-09-27]
03_CAD/strip_3ch.step
1270.0 x 636.0 x 148.0 mm
