Partha-Sarath-0/demo/(list of files, cad)

Other CAD files:
03_CAD/strip_2ch.step
03_CAD/Grail_Collector_2.step
03_CAD/Grail_Collector_2.f3d
