Partha-Sarath-0/demo/15_Run_in_VSCode/requirements-tested.txt

numpy==2.4.4
scipy==1.17.1
pandas==3.0.2
scikit-learn==1.8.0
matplotlib==3.10.9
shap==0.51.0
pymoo==0.6.2
pvlib==0.15.2
