Partha-Sarath-0/demo/14_Xcos_block_diagram_model/xcos_results.csv

arrangement | n_modules | Q_coll_kWh | Q_loss_kWh | Q_draw_kWh | Q_solar_kWh | Q_load_kWh | pump_h | solar_fraction | Tt_end_K | Tc_max_K | closure_kWh | run_s
alternating | 2 | 875.0688 | 247.4734 | 626.0240 | 626.0240 | 768.8527 | 2834.80 | 0.814231 | 311.6838 | 347.962 | 4.435e-11 | 7
parallel | 2 | 921.9051 | 271.7412 | 648.4200 | 648.4200 | 768.8524 | 2839.84 | 0.843361 | 313.1696 | 352.030 | 5.851e-12 | 7
alternating | 4 | 1263.1744 | 509.2234 | 749.7092 | 749.7092 | 768.8544 | 2153.05 | 0.975099 | 334.6819 | 429.849 | 1.756e-11 | 9
parallel | 4 | 1292.9795 | 534.1814 | 754.0794 | 754.0794 | 768.8529 | 2056.03 | 0.980785 | 338.7897 | 443.822 | -5.925e-11 | 10
