Partha-Sarath-0/demo/12_Stages_3-5-6-7/optimisation/verification_vs_GRAIL-CHT.csv

arrangement | pick | eta_ann | eta_cht | std_ann | std_cht | dp_ann | dp_cht | Tmax_cht | converged | eta_err_pp | std_err_pct | dp_err_pct
alternating | max_eta | 0.5783396809372161 | 0.5784045931358048 | 2.872147953612248 | 2.833736084435269 | 11.349513495309292 | 10.731233539797 | 331.16749476694264 | True | -0.00649121985887291 | 1.3555203460181737 | 5.761499395380678
alternating | min_std | 0.5773477095586155 | 0.5781669983215713 | 2.827119022391441 | 2.866042013611642 | 20.186822514733244 | 20.17955103179932 | 331.27216791210554 | True | -0.08192887629557832 | -1.3580746909970152 | 0.036033918309008865
alternating | knee | 0.5599334846351087 | 0.5601425484400887 | 4.800084215885446 | 4.8160331312619515 | 7.506468502127948 | 7.547142893978121 | 340.341762743778 | True | -0.02090638049799809 | -0.3311629081821951 | -0.5389376141616058
parallel | max_eta | 0.593998900538118 | 0.5943249543820797 | 3.7130349574170807 | 3.7626445233929204 | 11.261201030896554 | 10.697312629797816 | 327.8280445865765 | True | -0.032605384396167114 | -1.3184760257688368 | 5.27130897836905
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
