Partha-Sarath-0/demo/12_Stages_3-5-6-7/system_model/virtual_test_matrix.csv

arrangement | G_T | T_in | T_amb | v_wind | bridge_mm | g_ratio | lam_G | mdot_total | T_out_K | dT_fluid_K | Qu_W | eta | T_plate_mean_K | T_plate_max_K | T_plate_min_K | plate_spread_K | plate_std_K | dp_channel_Pa | T_glass_mean_K | converged | e110 | e220 | it | eta_110 | eta_220
alternating | 500.0 | 293.15 | 303.15 | 3.0 | 31.285944 | 0.539935 | 1.0 | 0.00275 | 307.058683479511 | 13.908683479511012 | 159.88031659697907 | 0.6056072598370419 | 311.2340277625729 | 316.17016427910323 | 299.4779576826951 | 16.69220659640814 | 4.19669008036926 | 37.384910092395515 | 301.27444701501145 | True | 0.0001136131483711097 | 0.00011383836353466109 | 494 | 0.6067234408473738 | 0.6061653503422079
alternating | 500.0 | 308.15 | 303.15 | 3.0 | 31.285944 | 0.539935 | 1.0 | 0.00275 | 320.7616859846332 | 12.611685984633198 | 144.9713303933586 | 0.5491338272475705 | 324.6995131414677 | 329.2673540582264 | 313.79677850513076 | 15.470575553095614 | 3.889616522550084 | 27.885113947424724 | 302.3621258085525 | True | 0.00011776874838901481 | 0.00011888492184016058 | 498 | 0.5502063546067244 | 0.5496700909271475
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
