Partha-Sarath-0/demo/12_Stages_3-5-6-7/system_model/virtual_test_matrix_with_x.csv

arrangement | G_T | T_in | T_amb | v_wind | bridge_mm | g_ratio | lam_G | mdot_total | T_out_K | dT_fluid_K | Qu_W | eta | T_plate_mean_K | T_plate_max_K | T_plate_min_K | plate_spread_K | plate_std_K | dp_channel_Pa | T_glass_mean_K | converged | e110 | e220 | it | eta_110 | eta_220 | Tm | dT | x | q | x_in
alternating | 500.0 | 293.15 | 303.15 | 3.0 | 31.285944 | 0.539935 | 1.0 | 0.00275 | 307.058683479511 | 13.908683479511012 | 159.88031659697907 | 0.6056072598370419 | 311.2340277625729 | 316.17016427910323 | 299.4779576826951 | 16.69220659640814 | 4.19669008036926 | 37.38491009239552 | 301.27444701501145 | True | 0.0001136131483711 | 0.0001138383635346 | 494 | 0.6067234408473738 | 0.6061653503422079 | 300.10434173975545 | -3.0456582602445224 | -0.0060913165204890445 | 302.8036299185209 | -0.02
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
