Partha-Sarath-0/demo/12_Stages_3-5-6-7/surrogate/test_parity_T_plate_mean_K.csv

case_id | true | pred | pred_std
PAR_071 | 332.31855414604416 | 332.36675439664566 | 0.12898037148399014
PAR_041 | 329.2066622565519 | 329.04713473488926 | 0.08449541926985892
PAR_088 | 299.3238795340518 | 299.5226537343148 | 0.08013384663977592
PAR_124 | 312.1094590901258 | 312.3340735727592 | 0.11694008715079283
PAR_001 | 309.8162873646046 | 309.465965955004 | 0.13369872979709907
PAR_091 | 340.99920414213426 | 341.13088977402447 | 0.09519485355514941
ALT_104 | 349.9888066960905 | 350.06886339052056 | 0.15758482495935786
PAR_140 | 340.67379670795094 | 340.7378787436512 | 0.09787764683444009
ALT_027 | 341.60104207813 | 341.70243231119906 | 0.07320729993240295
PAR_048 | 324.6398649840532 | 324.7882733578746 | 0.11310349803432009
ALT_138 | 387.4916329814852 | 384.50233841200543 | 0.3790786410333171
ALT_102 | 314.97726142745324 | 315.0360416263857 | 0.10670972735064228
PAR_106 | 314.94463039335955 | 314.89620461732164 | 0.12311958258385088
ALT_070 | 355.63481640554846 | 356.1342188907397 | 0.12236484608916653
ALT_028 | 307.6857797386612 | 307.541723809902 | 0.07979832081944067
ALT_142 | 334.041177628844 | 333.75279499499266 | 0.16174731164379388
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
