Partha-Sarath-0/demo/12_Stages_3-5-6-7/surrogate/test_parity_eta.csv

case_id | true | pred | pred_std
PAR_071 | 0.4716297507751055 | 0.4707834850419016 | 0.0005439270336942671
PAR_041 | 0.5259197852674934 | 0.526135762902402 | 0.0004530327933629734
PAR_088 | 0.6479693345231291 | 0.6479278061703153 | 0.00044388882617886255
PAR_124 | 0.604546594447295 | 0.6043176789360785 | 0.0008189140810031615
PAR_001 | 0.6455453650420525 | 0.645999579106133 | 0.0004632278563937646
PAR_091 | 0.565925439305678 | 0.5662074976763721 | 0.0005110534981258926
ALT_104 | 0.5618246913477413 | 0.5619869449675019 | 0.0006555393355842792
PAR_140 | 0.5011704970504609 | 0.5001327416954471 | 0.0006771794713082209
ALT_027 | 0.4985747641294351 | 0.4981344995728258 | 0.00025715757431762714
PAR_048 | 0.5974916541290554 | 0.5971055301826604 | 0.0003480949529144024
ALT_138 | 0.4437627150146358 | 0.4462608021551445 | 0.001079720600894167
ALT_102 | 0.5180664068136497 | 0.5186543728936663 | 0.0008890038444296829
PAR_106 | 0.6296816855634342 | 0.6297436779413137 | 0.0007581988207485367
ALT_070 | 0.5146326063169406 | 0.5125573150697071 | 0.0005006115717489507
ALT_028 | 0.5857534056127403 | 0.5849662163987929 | 0.00045589167560929213
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
