Partha-Sarath-0/demo/12_Stages_3-5-6-7/surrogate/test_parity_log_dp_Pa.csv

case_id | true | pred | pred_std
PAR_071 | 2.050401500415159 | 2.0510556967461833 | 0.007130576604959046
PAR_041 | 1.3442971664691588 | 1.3255382944230267 | 0.009561102612125123
PAR_088 | 2.9843796023317717 | 2.972388469674704 | 0.007511995164335718
PAR_124 | 2.7610214412213963 | 2.7682504786580404 | 0.008264190587661311
PAR_001 | 4.085731091242841 | 4.088453011370679 | 0.013868366731705911
PAR_091 | 2.067103665173512 | 2.0605245958889227 | 0.003559976189791074
ALT_104 | 4.1806220408889505 | 4.186232733857029 | 0.013693718459072222
PAR_140 | 2.20262314223709 | 2.213270803902163 | 0.008599181495649226
ALT_027 | 3.1516827857543723 | 3.139257905659894 | 0.005988032890885389
PAR_048 | 4.37216745641088 | 4.377622656664908 | 0.00789295154046997
ALT_138 | 1.0527520578086949 | 1.03749589012136 | 0.008577855150918953
ALT_102 | 3.2638496515093887 | 3.2643263742373754 | 0.0069441357849796825
PAR_106 | 2.4925467039237024 | 2.4894975239416572 | 0.003283603178406637
ALT_070 | 2.352707428781746 | 2.338565919306953 | 0.0067014434478728105
ALT_028 | 3.9748759212805767 | 3.982849899337084 | 0.009336783609929495
ALT_142 | 3.372943542454046 | 3.3539009737368133 | 0.01717993068355036
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
