Partha-Sarath-0/demo/12_Stages_3-5-6-7/surrogate/test_parity_plate_std_K.csv

case_id | true | pred | pred_std
PAR_071 | 3.536707893663536 | 3.5260415493067634 | 0.017236166504381995
PAR_041 | 10.663512418571369 | 10.742052353538593 | 0.05842411407376754
PAR_088 | 4.86492000560694 | 4.864905600828099 | 0.018784111331891746
PAR_124 | 3.8772479356336 | 3.8753881110316897 | 0.04211780189521231
PAR_001 | 6.627371766479743 | 6.569751138712047 | 0.07062974828042694
PAR_091 | 10.145015983669852 | 10.144638873018529 | 0.024951929093891528
ALT_104 | 6.523384059833222 | 6.580754775209213 | 0.03090059036997796
PAR_140 | 5.1733468400514 | 5.182133427228573 | 0.026421256400167483
ALT_027 | 2.9986847266077863 | 2.983516619762395 | 0.014585037149563721
PAR_048 | 5.3709384149837 | 5.389208778943299 | 0.016369225477530874
ALT_138 | 19.468339879352616 | 19.055718636203743 | 0.18950344454931894
ALT_102 | 2.333021273308401 | 2.314738322927502 | 0.032117764137457386
PAR_106 | 4.17695953239348 | 4.20986633754269 | 0.0123443882567185
ALT_070 | 14.303101730256154 | 14.369550894285544 | 0.036662057807587016
ALT_028 | 2.892976288481195 | 2.9042238735744563 | 0.029362458281288212
ALT_142 | 5.01914212866467 | 4.990130329204487 | 0.03355242644350994
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
