Partha-Sarath-0/demo/13_Octave_system_model/octave_results.csv

arrangement | n_modules | aperture_m2 | solar_fraction | Q_solar_kWh | Q_load_kWh | tank_loss_kWh | max_collector_K | pump_kWh | closure_kWh | capex_Rs | net_saving_Rs | simple_payback_yr | discounted_payback_yr | NPV_Rs | LCOH_Rs_kWh
alternating | 1 | 0.528 | 0.500458 | 384.778 | 768.851 | 110.813 | 329.05 | 45.871 | 1.33e-12 | 16500 | 1523.05 | 10.834 | 27 | -3463.5 | 5.9990
alternating | 2 | 1.056 | 0.830359 | 638.423 | 768.851 | 241.532 | 349.08 | 42.543 | -3.35e-13 | 21000 | 2748.56 | 7.640 | 13 | 2526.2 | 4.4851
alternating | 3 | 1.584 | 0.947479 | 728.471 | 768.851 | 402.238 | 389.44 | 38.438 | 9.73e-13 | 25500 | 3168.36 | 8.048 | 14 | 1619.5 | 4.6876
alternating | 4 | 2.112 | 0.979134 | 752.808 | 768.851 | 508.777 | 426.59 | 31.990 | 1.69e-12 | 30000 | 3274.06 | 9.163 | 18 | -1975.7 | 5.2540
parallel | 1 | 0.528 | 0.531719 | 408.813 | 768.851 | 118.155 | 330.79 | 46.249 | -3.31e-14 | 16500 | 1640.17 | 10.060 | 22 | -2461.0 | 5.6507
parallel | 2 | 1.056 | 0.858378 | 659.965 | 768.851 | 266.453 | 353.16 | 42.644 | -3.34e-12 | 21000 | 2854.66 | 7.356 | 12 | 3434.4 | 4.3394
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
