Partha-Sarath-0/demo/17_Simulink_MATLAB_model/GRAIL_system_v21 Landscape.pdf

# GRAIL_system_v21

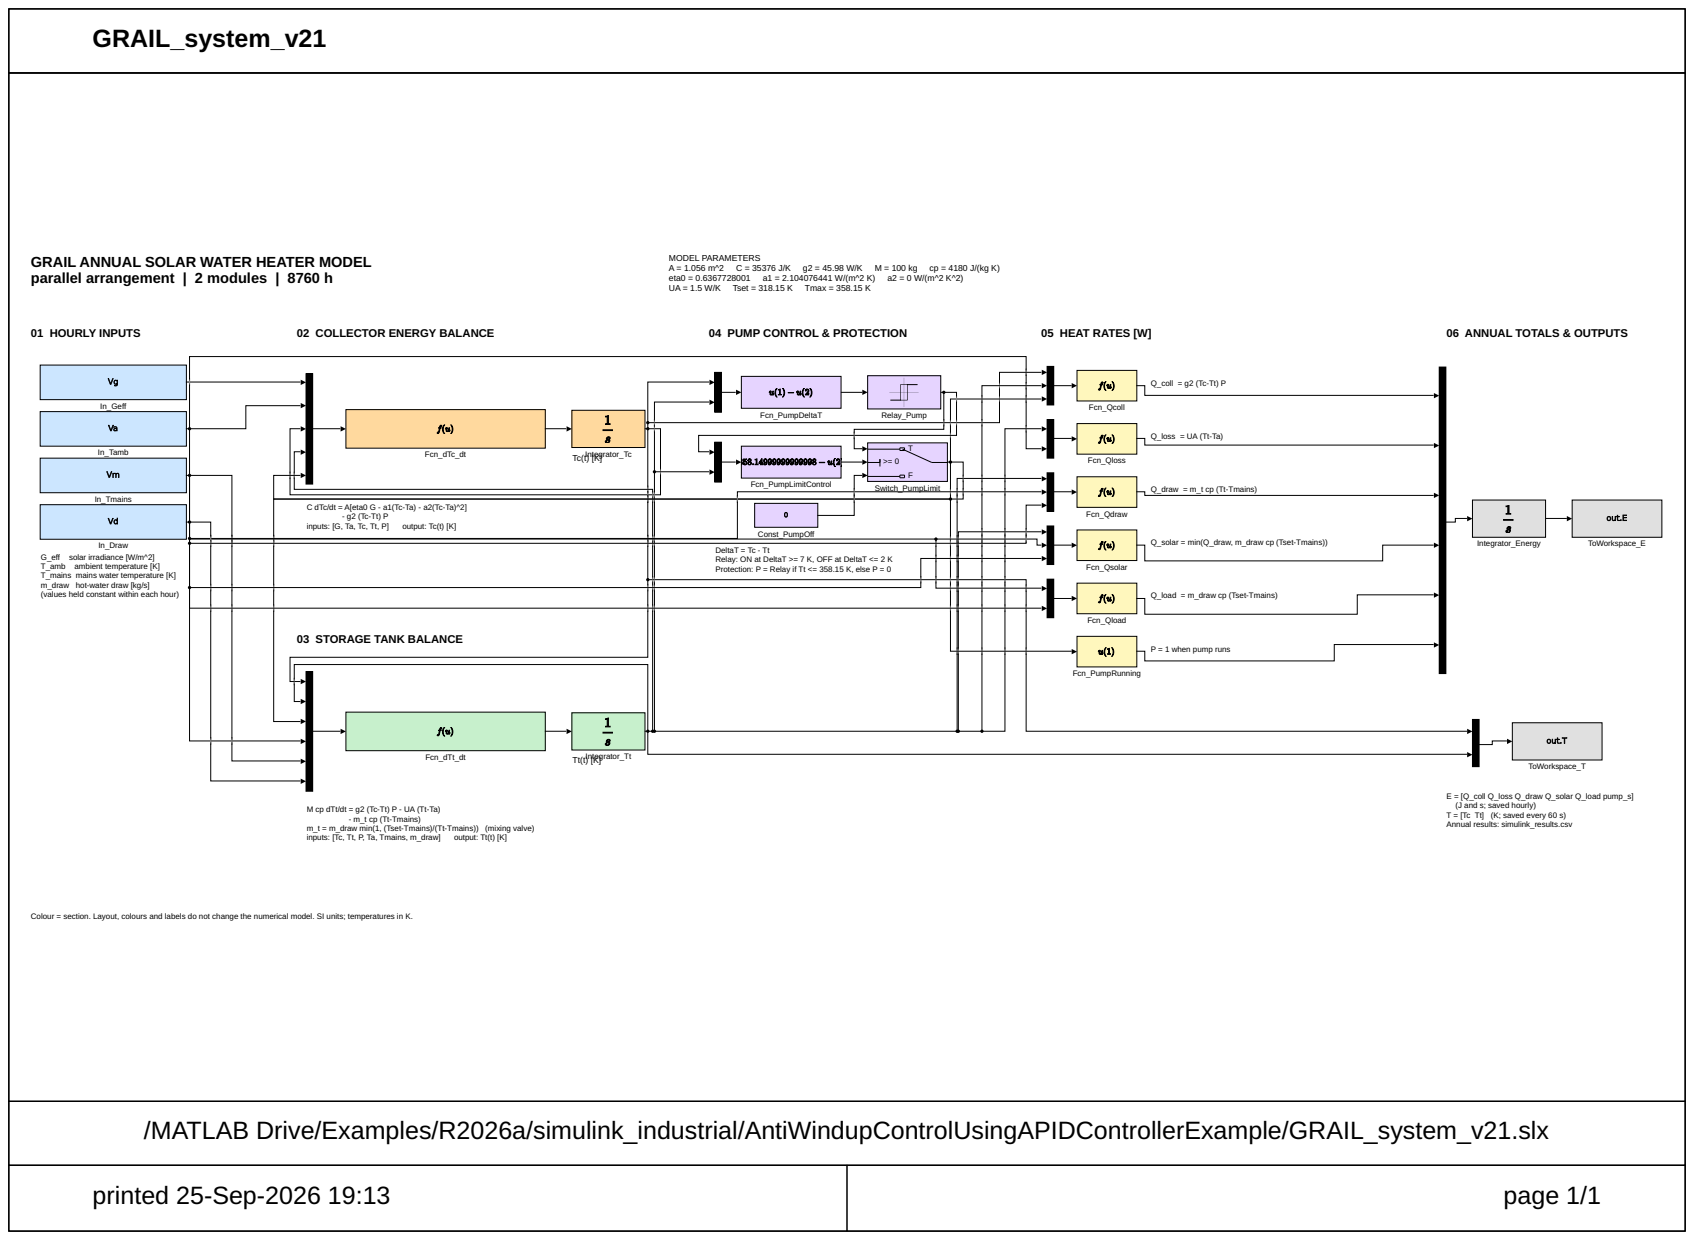
[picture p99: page 1]
Q_coll = g2 (Tc-Tt) P; inputs: [Tc, Tt, P, Ta, Tmains, m_draw]; output: Tt(t) [K]; inputs: [G, Ta, Tc, Tt, P]; output: Tc(t) [K]; 04 PUMP CONTROL & PROTECTION; 05 HEAT RATES [W]; 06 ANNUAL TOTALS & OUTPUTS; 01 HOURLY INPUTS; 02 COLLECTOR ENERGY BALANCE; MODEL PARAMETERS; cp = 4180 J/(kg K) eta0 = 0.6367728001; Tset = 318.15 K; Tmax = 358.15 K; In_Geff; In_Tamb; In_Tmains; In_Draw; Fcn_dTc_dt; Integrator_Tc; Fcn_dTt_dt; Integrator_Tt; Fcn_PumpDeltaT; Relay_Pump; Fcn_PumpLimitControl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

GRAIL ANNUAL SOLAR WATER HEATER MODEL
parallel arrangement | 2 modules | 8760 h

Q_loss = UA (Tt-Ta)

C dTc/dt = A[eta0 G - a1(Tc-Ta) - a2(Tc-Ta)^2]

Q_draw = m_t cp (Tt-Tmains)

Q_solar = min(Q_draw, m_draw cp (Tset-Tmains))

G_eff solar irradiance [W/m^2] T_amb ambient temperature [K] T_mains mains water temperature [K] m_draw hot-water draw [kg/s]

DeltaT = Tc - Tt Relay: ON at DeltaT >= 7 K, OFF at DeltaT <= 2 K

Protection: P = Relay if Tt <= 358.15 K, else P = 0

(values held constant within each hour)

Q_load = m_draw cp (Tset-Tmains)

03 STORAGE TANK BALANCE

P = 1 when pump runs

M cp dTt/dt = g2 (Tc-Tt) P - UA (Tt-Ta)
- m_t cp (Tt-Tmains) m_t = m_draw min(1, (Tset-Tmains)/(Tt-Tmains)) (mixing valve)

E = [Q_coll Q_loss Q_draw Q_solar Q_load pump_s]
(J and s; saved hourly) T = [Tc Tt] (K; saved every 60 s) Annual results: simulink_results.csv

Colour = section. Layout, colours and labels do not change the numerical model. SI units; temperatures in K.

/MATLAB Drive/Examples/R2026a/simulink_industrial/AntiWindupControlUsingAPIDControllerExample/GRAIL_system_v21.slx

# Sample Times for 'GRAIL_system_v21'

Color Annotation | Description | Value
Cont | Continuous
FiM | Fixed in Minor Step
D1 | Discrete 1 | 60
D2 | Discrete 2 | 3.6000e+03
Inf | Constant
